MoebiusTech/MecanumRobot-ArduinoMega2560/bord.jpg

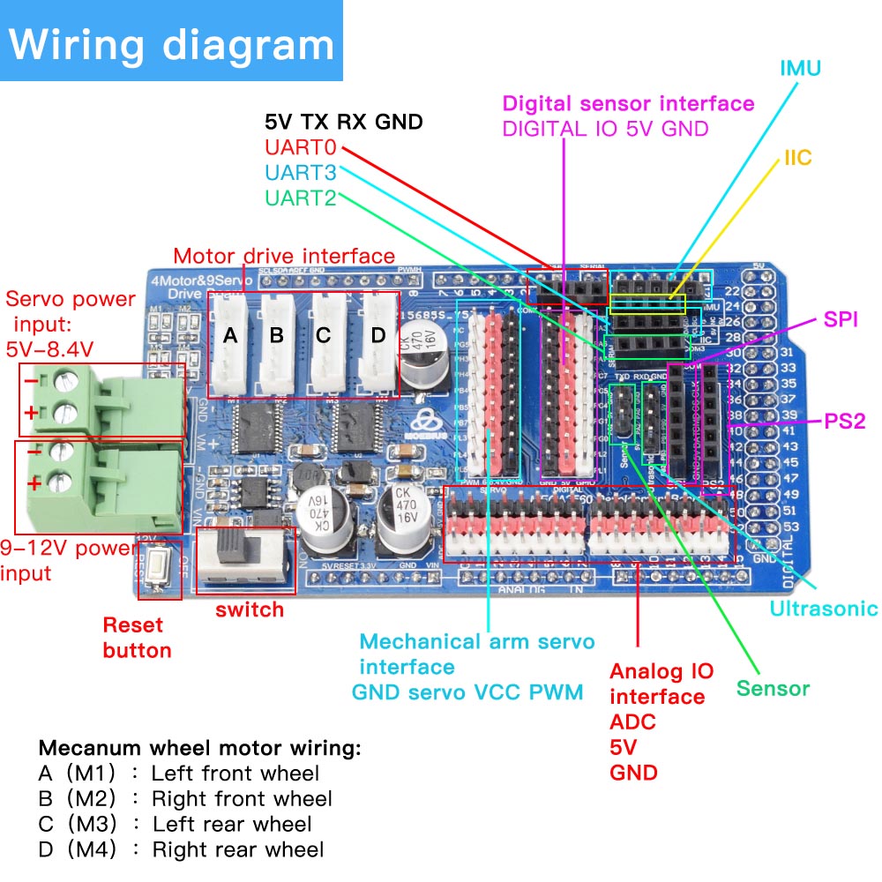
bord.jpg
