MoebiusTech/MecanumRobot-ArduinoMega2560/Encoder interface.png

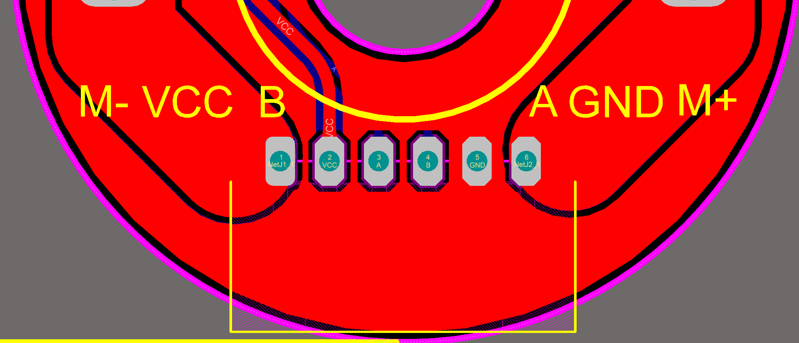
Encoder interface.png
