MoebiusTech/MecanumRobot-ArduinoMega2560/MecanumRobotPS2control.png

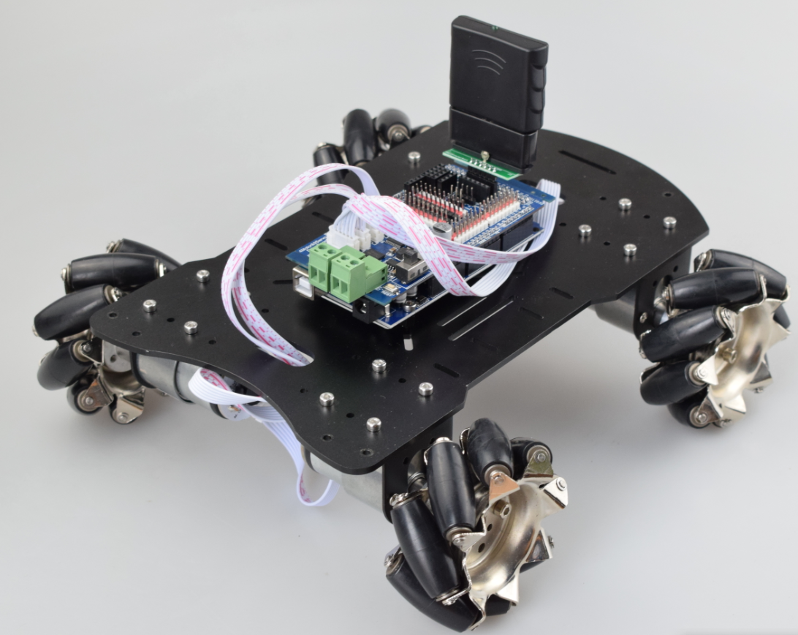
MecanumRobotPS2control.png
