MoebiusTech/MecanumRobot-ArduinoMega2560/Assembly Steps/01 - Attach Wheel Mounts.jpeg

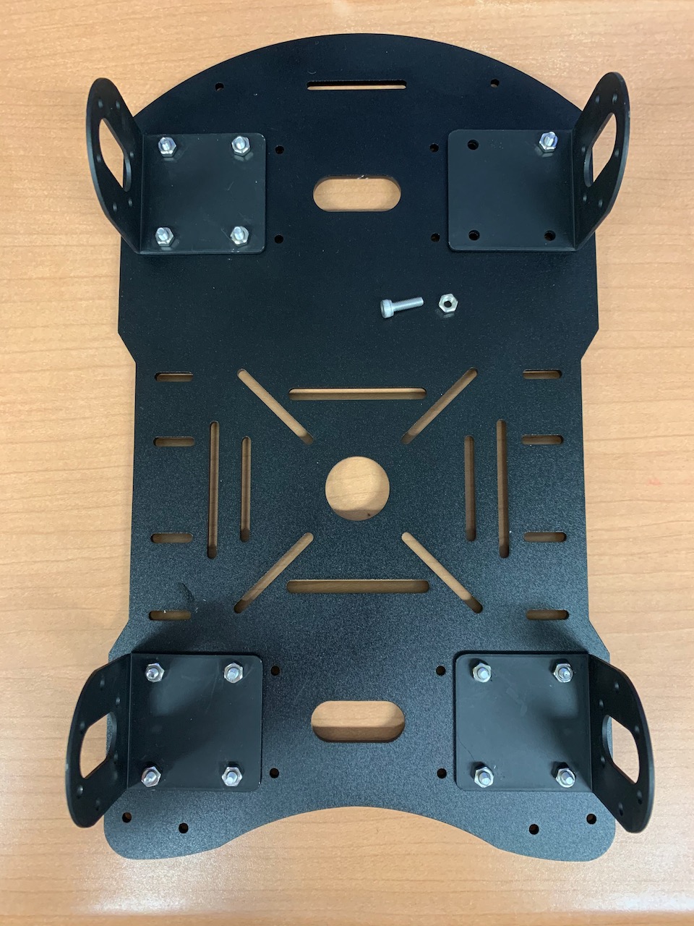
Assembly Steps/01 - Attach Wheel Mounts.jpeg
