MoebiusTech/MecanumRobot-ArduinoMega2560/Assembly Steps/02 - Plan Motors so Connectors are Oriented Inwards.jpeg

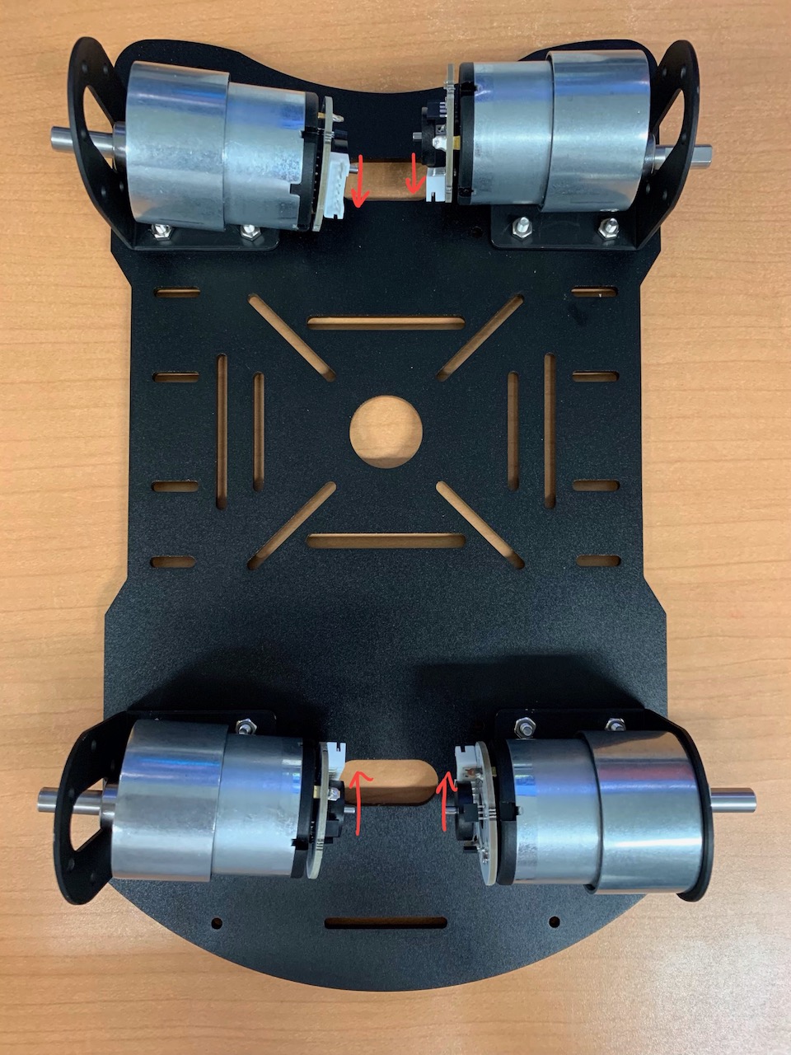
Assembly Steps/02 - Plan Motors so Connectors are Oriented Inwards.jpeg
