MoebiusTech/MecanumRobot-ArduinoMega2560/Assembly Steps/03 - Screw in Motors.jpeg

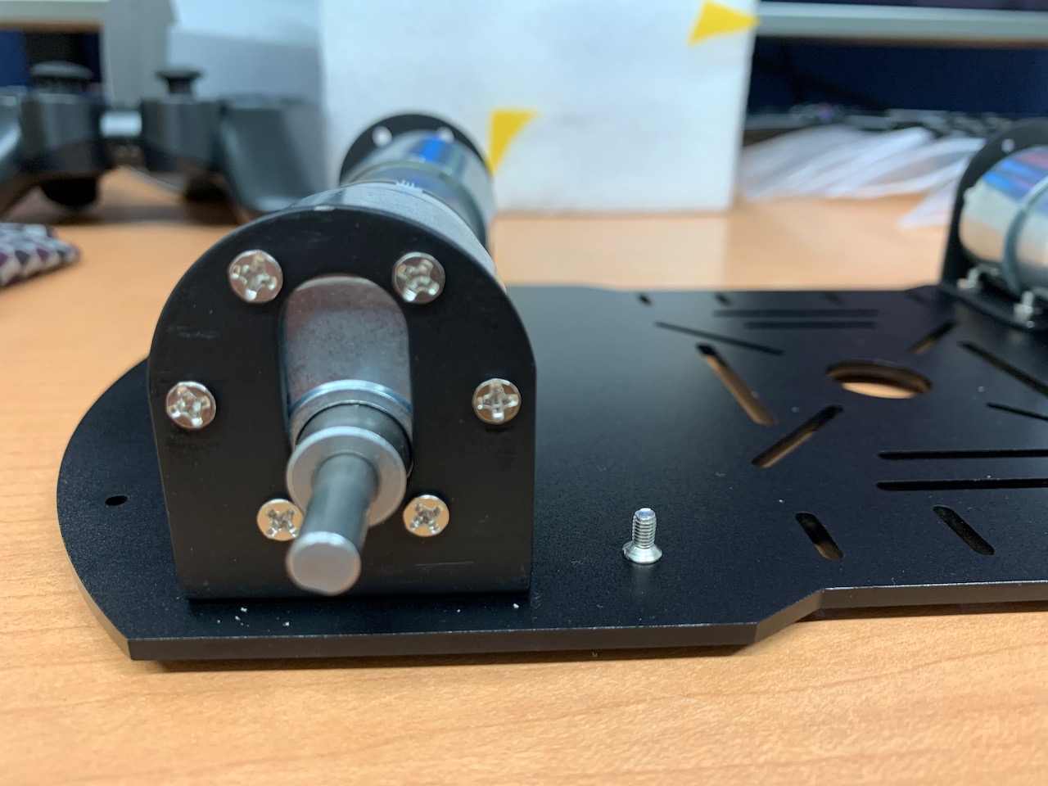
Assembly Steps/03 - Screw in Motors.jpeg
