MoebiusTech/MecanumRobot-ArduinoMega2560/Assembly Steps/04 - Prepare Wheel Assembly.jpeg

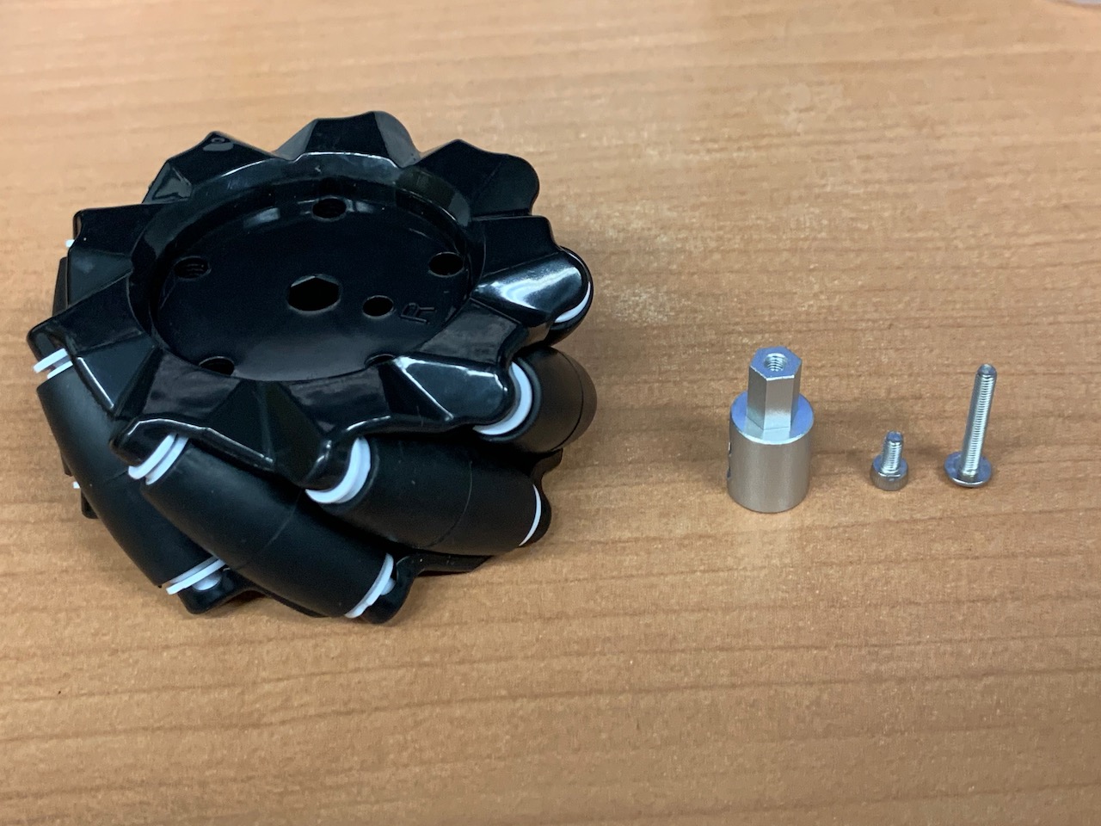
Assembly Steps/04 - Prepare Wheel Assembly.jpeg
