MoebiusTech/MecanumRobot-ArduinoMega2560/Assembly Steps/05 - Screw in Axle.jpeg

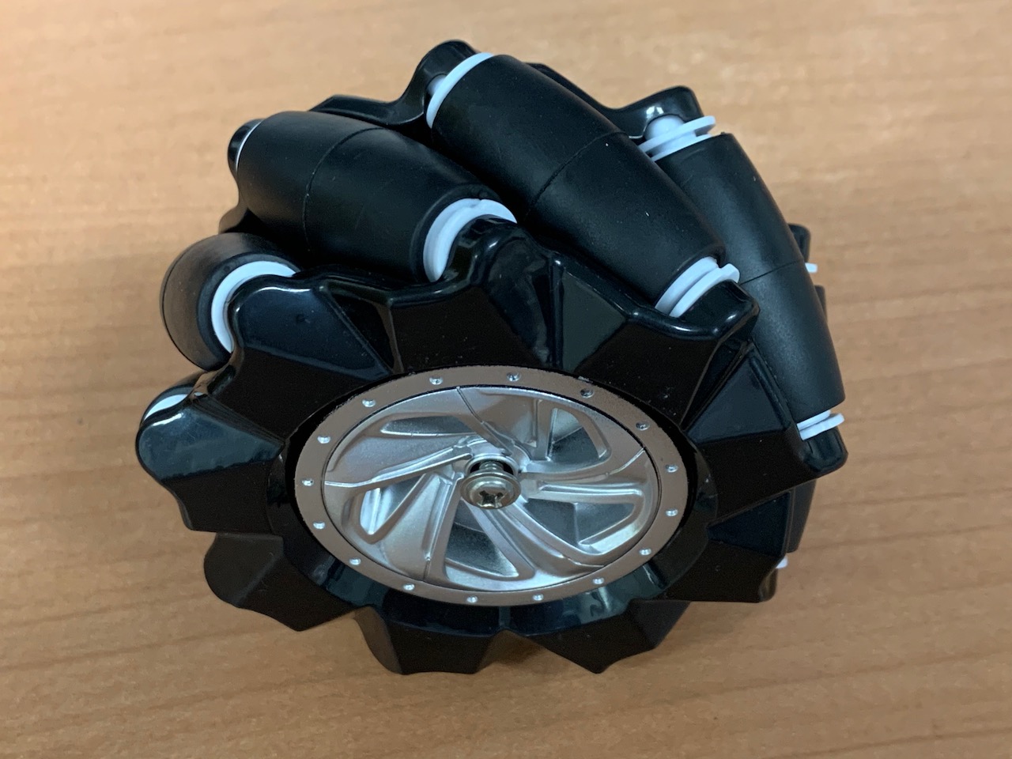
Assembly Steps/05 - Screw in Axle.jpeg
