MoebiusTech/MecanumRobot-ArduinoMega2560/Assembly Steps/06 - Prepare Set Screw.jpeg

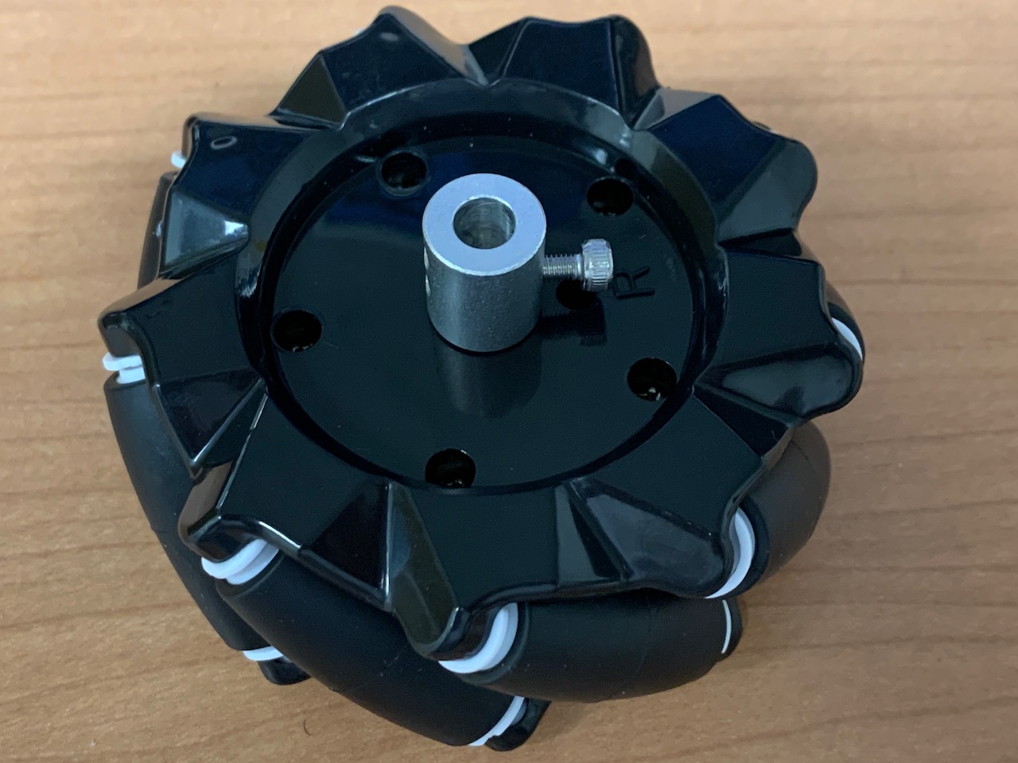
Assembly Steps/06 - Prepare Set Screw.jpeg
