MoebiusTech/MecanumRobot-ArduinoMega2560/Assembly Steps/07 - Wheels Ready.jpeg

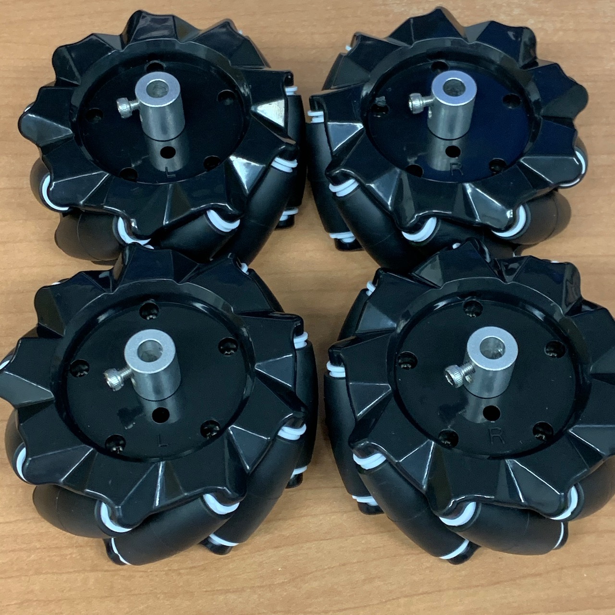
Assembly Steps/07 - Wheels Ready.jpeg
