MoebiusTech/MecanumRobot-ArduinoMega2560/Assembly Steps/08 - Align Wheel Set Screw to Axel Flat Area.jpeg

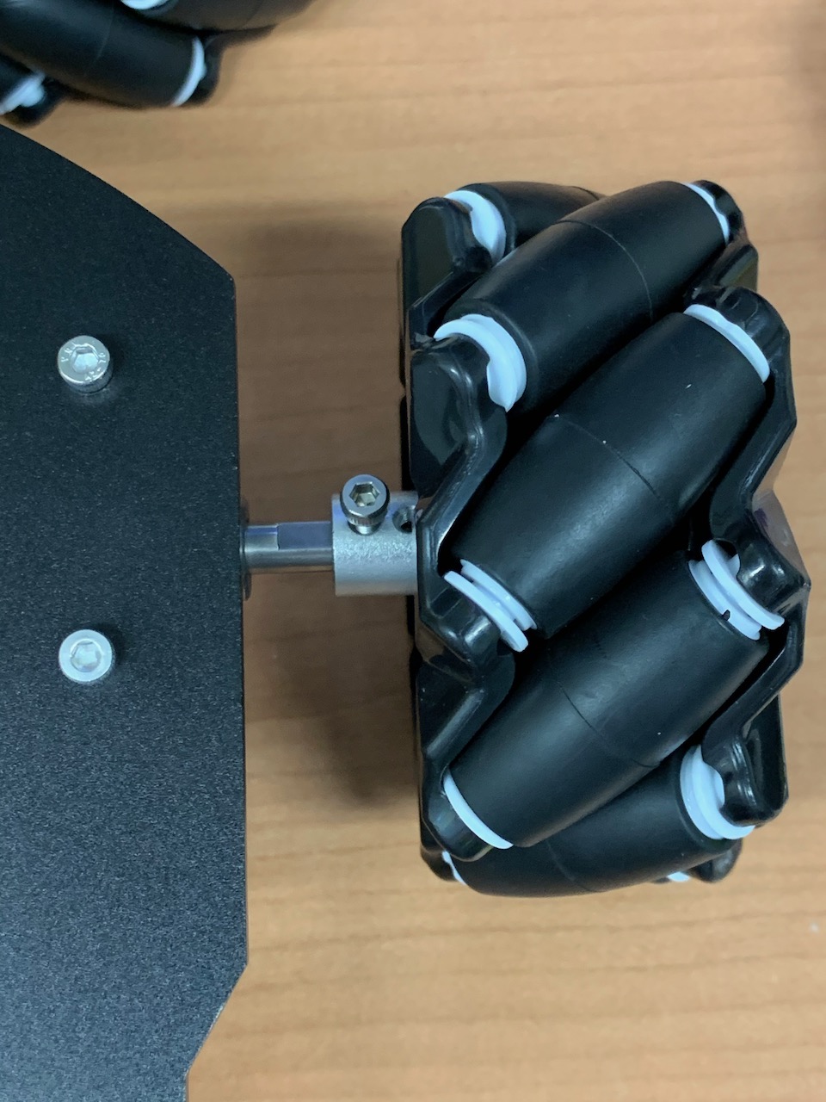
Assembly Steps/08 - Align Wheel Set Screw to Axel Flat Area.jpeg
