MoebiusTech/MecanumRobot-ArduinoMega2560/Assembly Steps/09 - Firmly Apply Set Screw.jpeg

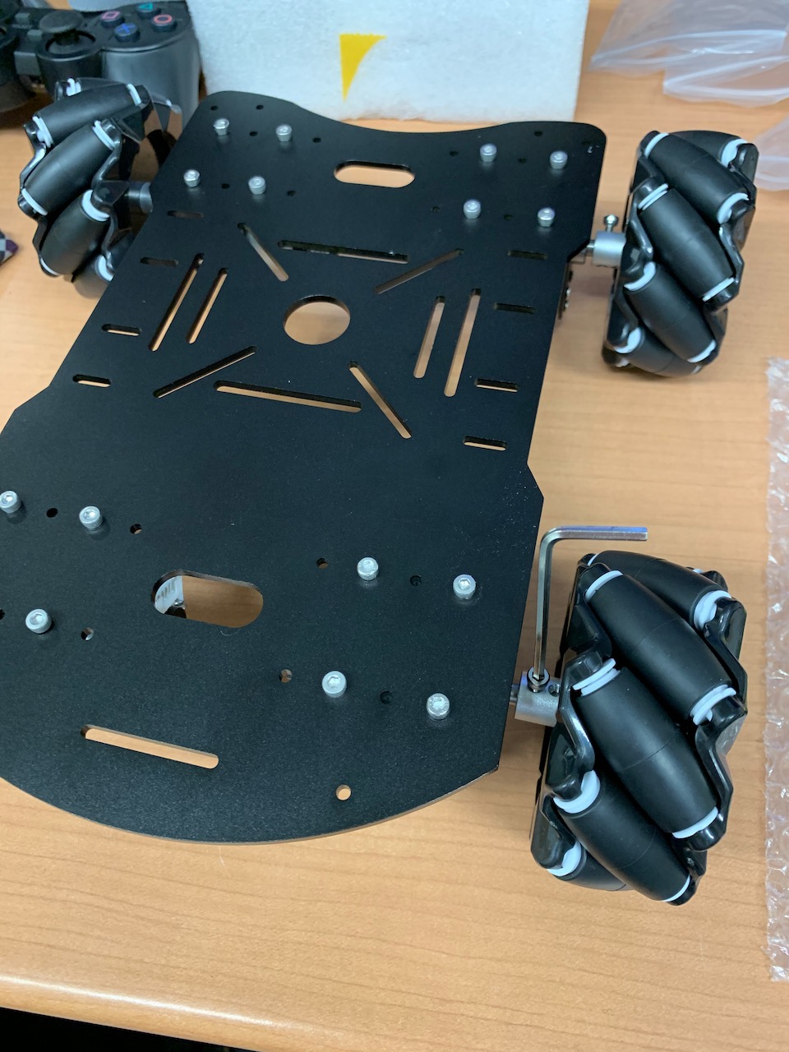
Assembly Steps/09 - Firmly Apply Set Screw.jpeg
