MoebiusTech/MecanumRobot-ArduinoMega2560/Assembly Steps/10 - Prepare Arduino Mega2560.jpeg

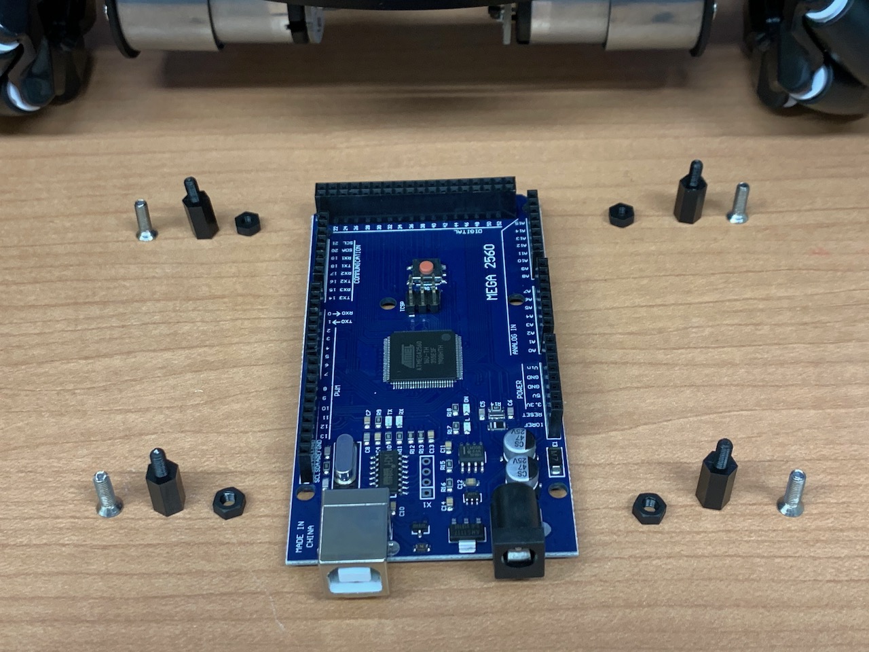
Assembly Steps/10 - Prepare Arduino Mega2560.jpeg
