MoebiusTech/MecanumRobot-ArduinoMega2560/Assembly Steps/11 - Plan Mounting Points.jpeg

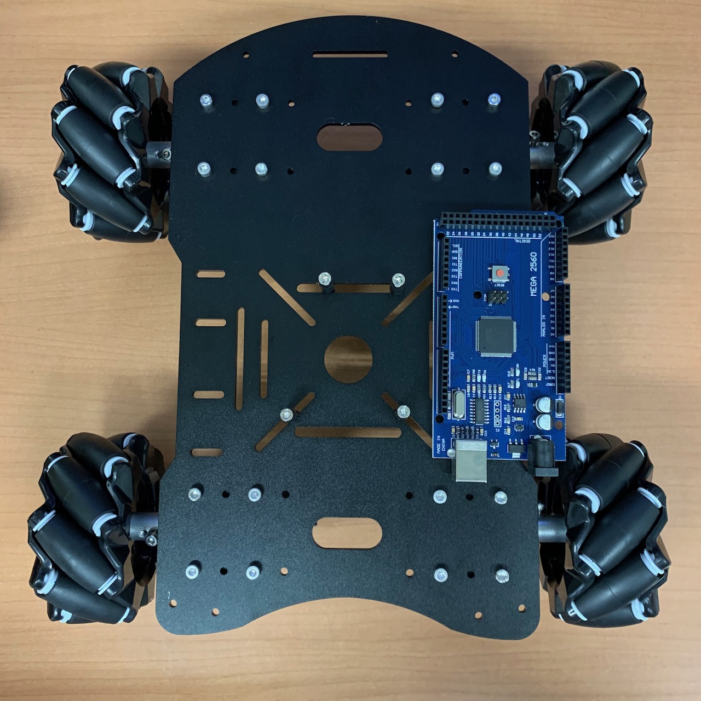
Assembly Steps/11 - Plan Mounting Points.jpeg
