MoebiusTech/MecanumRobot-ArduinoMega2560/Assembly Steps/12 - Mount Mega2560.jpeg

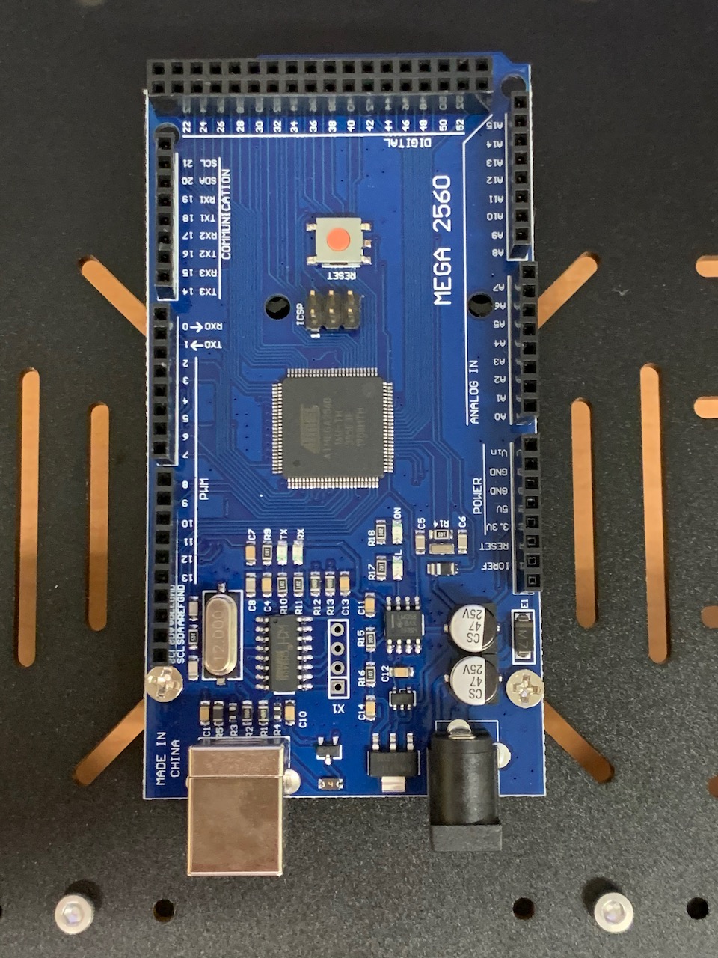
Assembly Steps/12 - Mount Mega2560.jpeg
