MoebiusTech/MecanumRobot-ArduinoMega2560/Assembly Steps/12 - Prepare IO Shield.jpeg

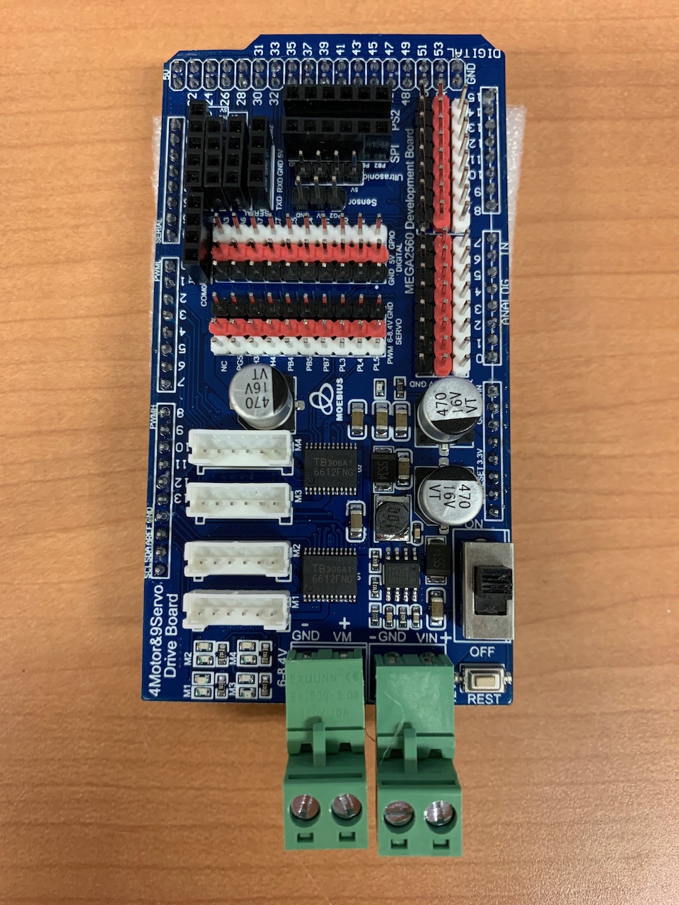
Assembly Steps/12 - Prepare IO Shield.jpeg
