MoebiusTech/MecanumRobot-ArduinoMega2560/Assembly Steps/13 - Align IO Shield to Mega2560.jpeg

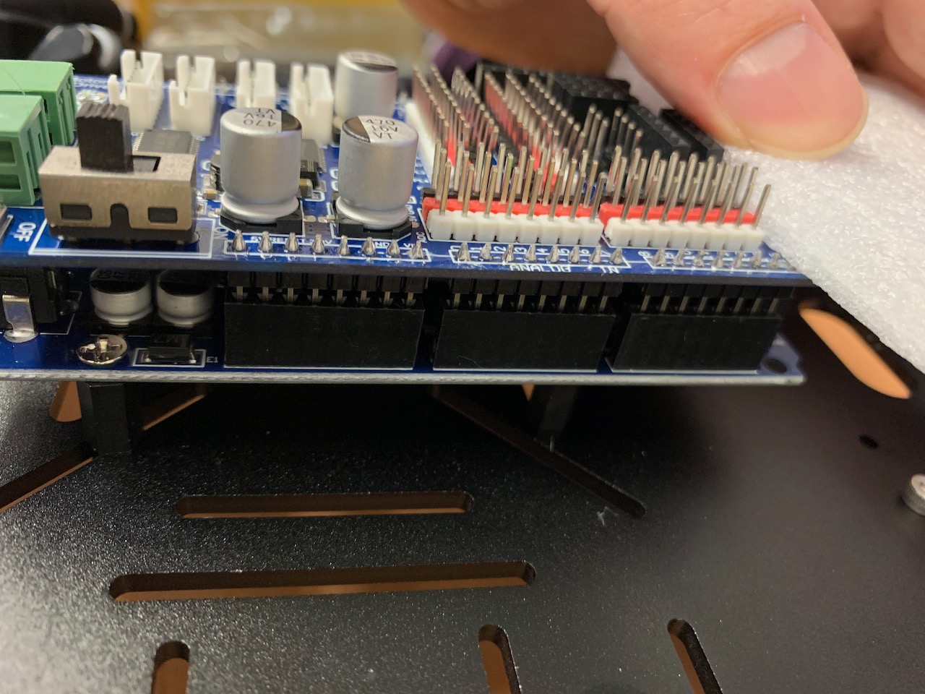
Assembly Steps/13 - Align IO Shield to Mega2560.jpeg
