MoebiusTech/MecanumRobot-ArduinoMega2560/Assembly Steps/14 - Use Foam to Press Firmly.jpeg

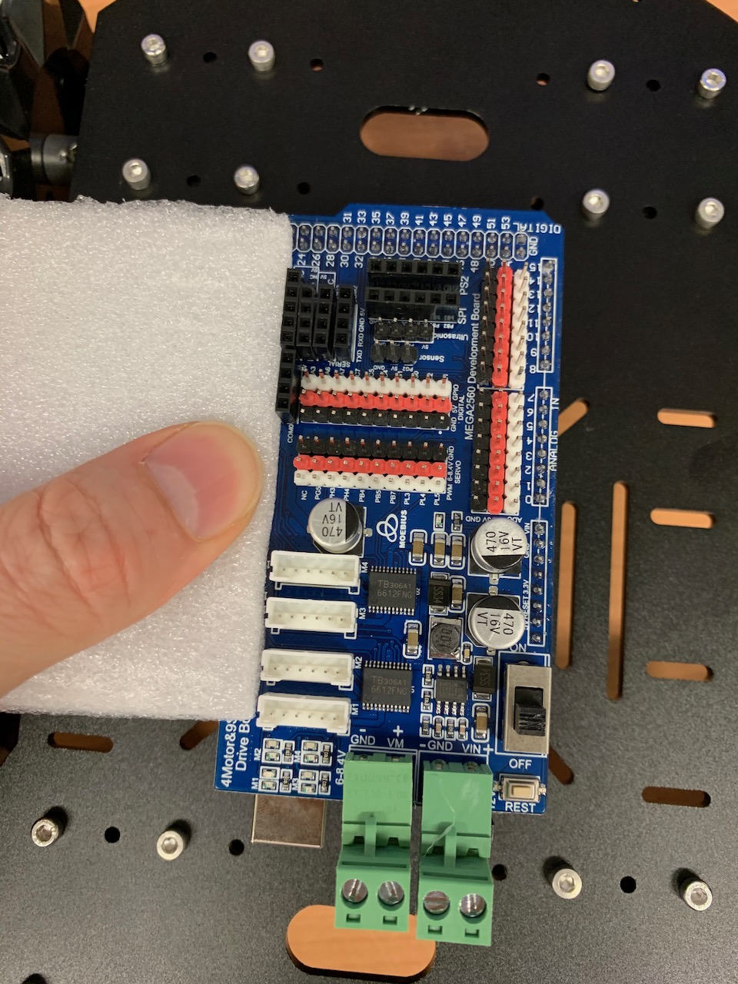
Assembly Steps/14 - Use Foam to Press Firmly.jpeg
