MoebiusTech/MecanumRobot-ArduinoMega2560/Assembly Steps/15 - Check Seating of Boards.jpeg

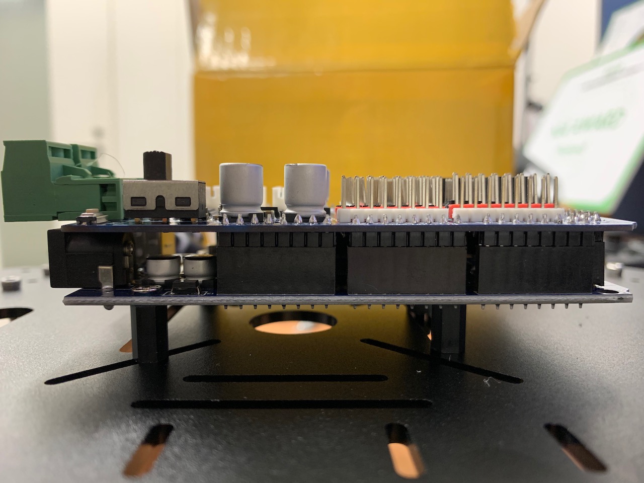
Assembly Steps/15 - Check Seating of Boards.jpeg
