MoebiusTech/MecanumRobot-ArduinoMega2560/Assembly Steps/16 - Prepare Motor Cables.jpeg

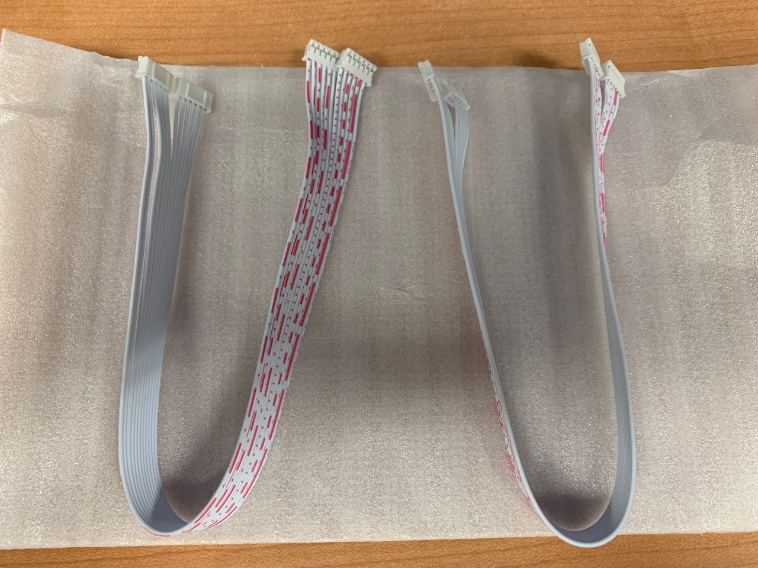
Assembly Steps/16 - Prepare Motor Cables.jpeg
