MoebiusTech/MecanumRobot-ArduinoMega2560/Assembly Steps/17 - Plug in Front Motors.jpeg

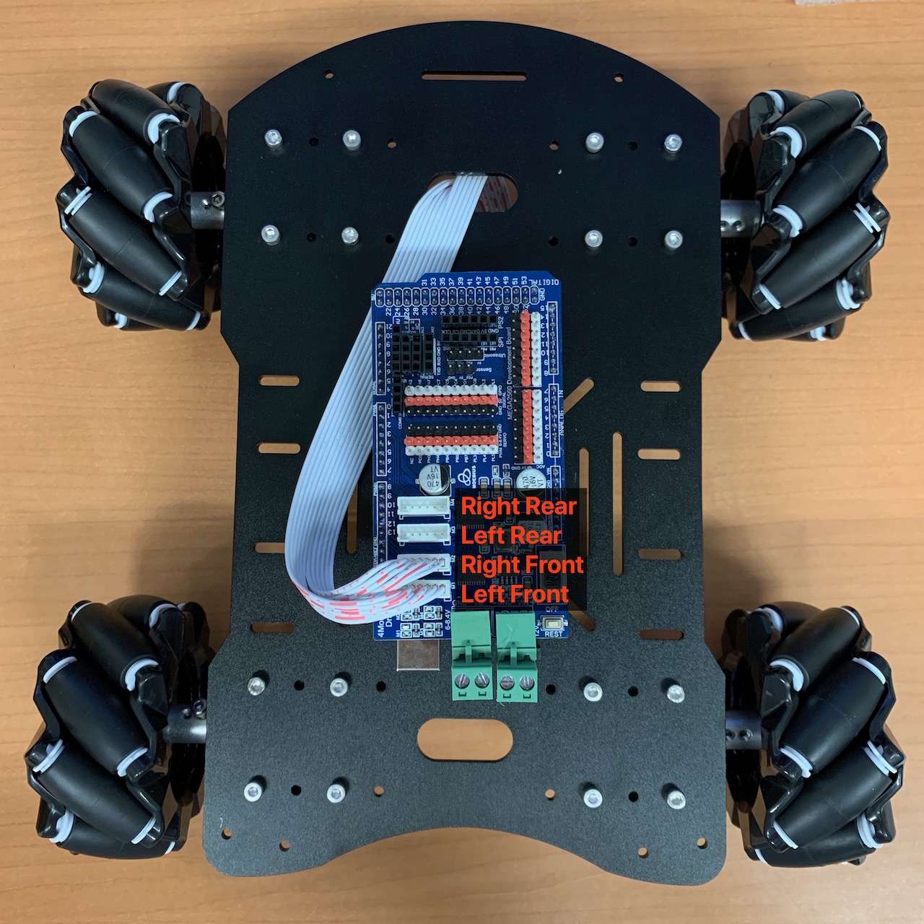
Assembly Steps/17 - Plug in Front Motors.jpeg
