MoebiusTech/MecanumRobot-ArduinoMega2560/Assembly Steps/18 - Front Motors Underside.jpeg

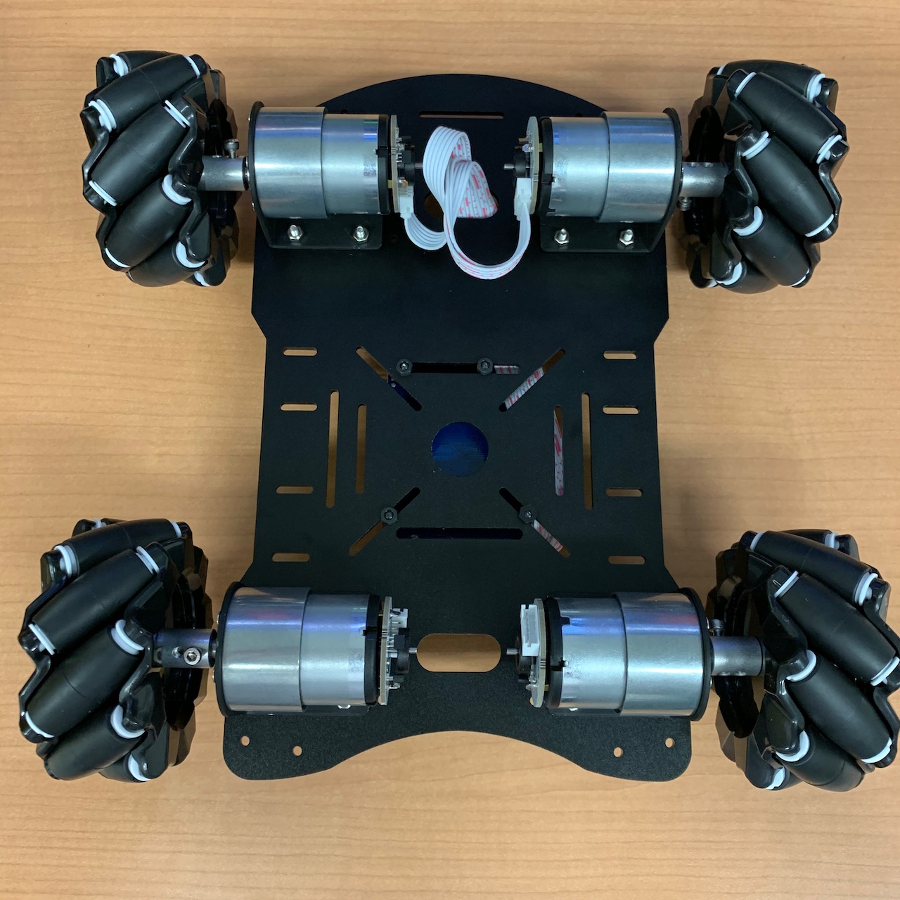
Assembly Steps/18 - Front Motors Underside.jpeg
