MoebiusTech/MecanumRobot-ArduinoMega2560/Assembly Steps/19 - Plug in Rear Motors (via center hole).jpeg

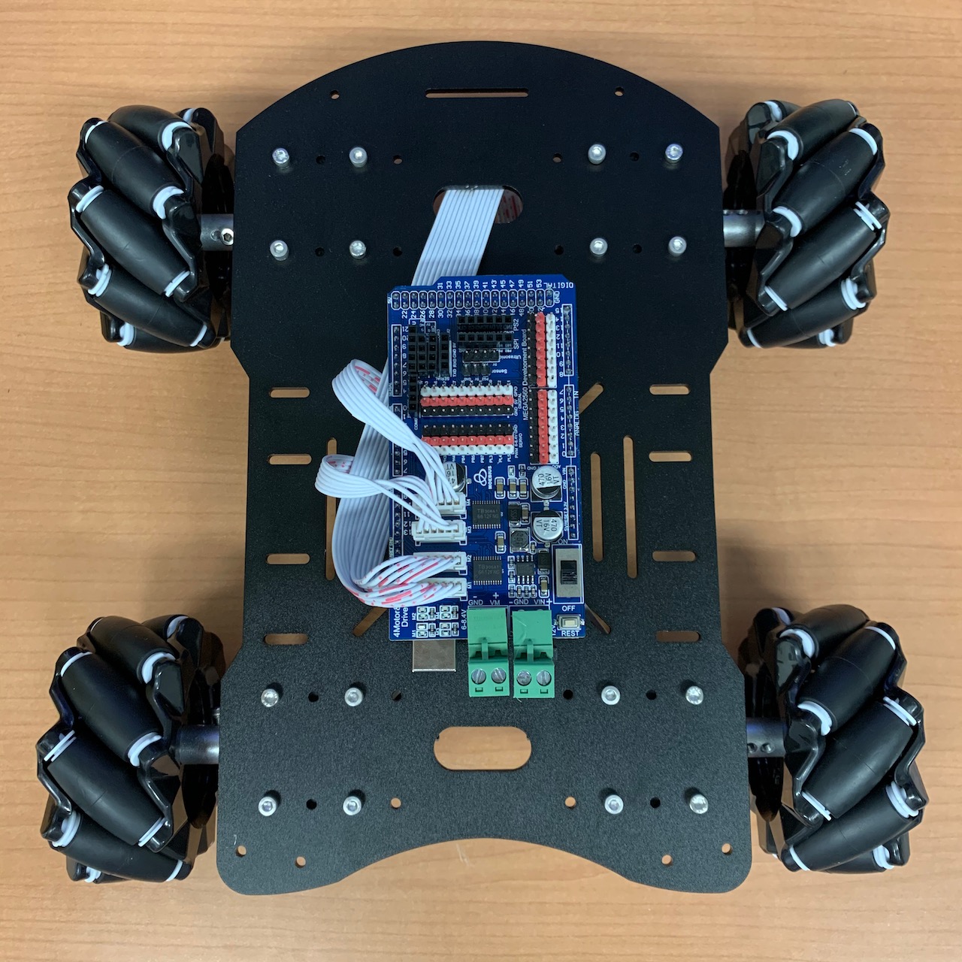
Assembly Steps/19 - Plug in Rear Motors (via center hole).jpeg
