MoebiusTech/MecanumRobot-ArduinoMega2560/Assembly Steps/20 - Rear Wheels via Center Hole.jpeg

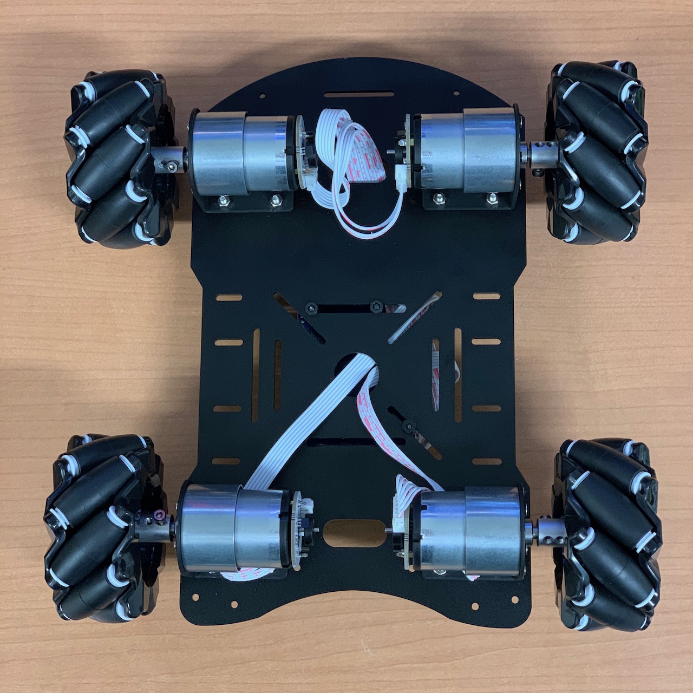
Assembly Steps/20 - Rear Wheels via Center Hole.jpeg
