MoebiusTech/MecanumRobot-ArduinoMega2560/Assembly Steps/21 - Plug in PS2 Receiver.jpeg

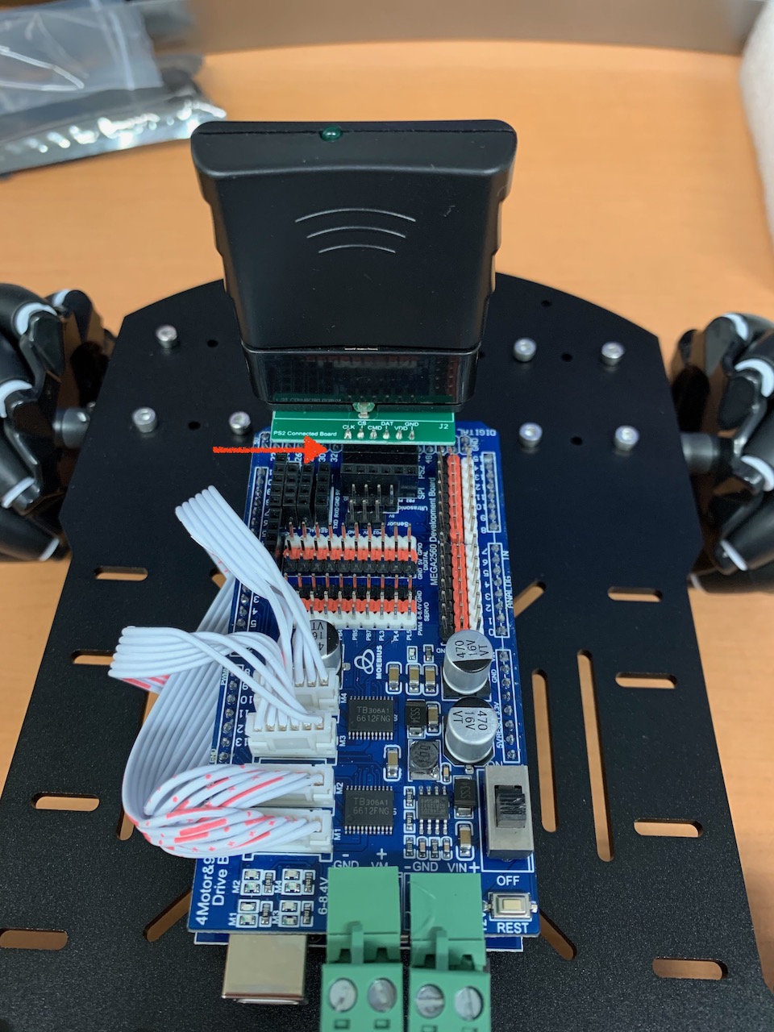
Assembly Steps/21 - Plug in PS2 Receiver.jpeg
