MoebiusTech/MecanumRobot-ArduinoMega2560/Assembly Steps/22 - PS2 Receiver Alignment.jpeg

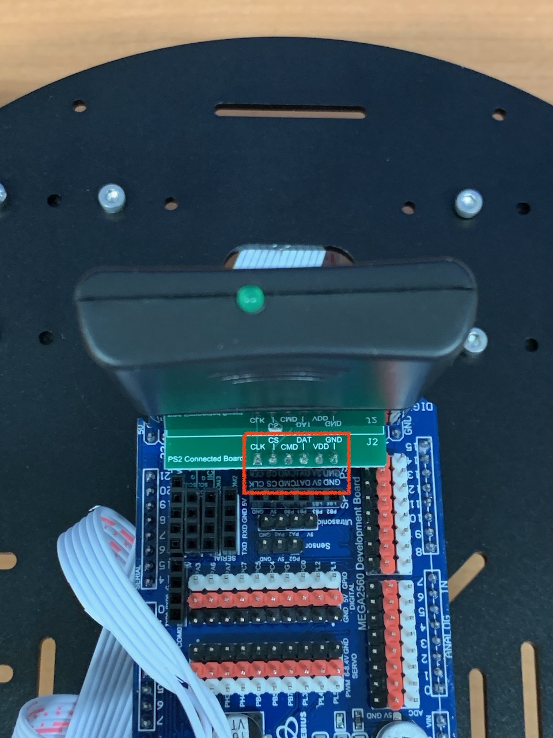
Assembly Steps/22 - PS2 Receiver Alignment.jpeg
