MoebiusTech/MecanumRobot-ArduinoMega2560/Assembly Steps/Pay attention to the direction of installing the wheels.jpg

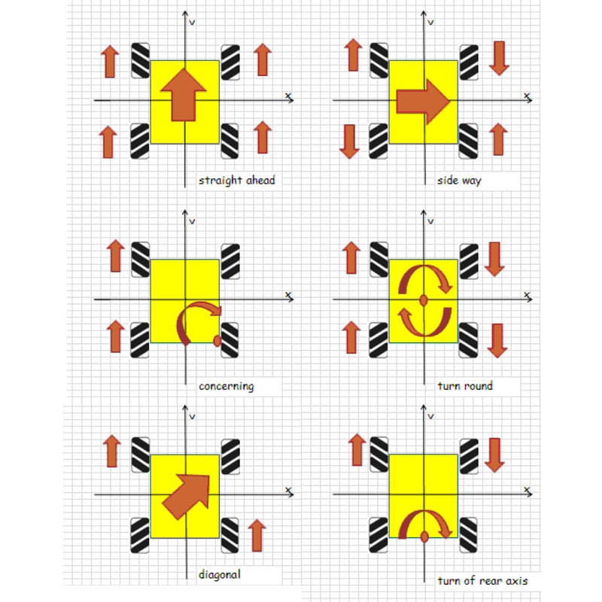
Assembly Steps/Pay attention to the direction of installing the wheels.jpg
