MoebiusTech/MecanumRobot-ArduinoMega2560/(threads)

Thread 1 (2019-11-20):

stm32

GreenGhostMan, 2019-11-20:
Where is stm32 repo and pin diagram . I want to contribute!

MoebiusTech, 2020-05-24:
The controller of stm32 will be online as soon as possible

Closed 2020-08-08.

Thread 4 (2020-05-12):

PS2 Analog issue

olaf-h, 2020-05-12:
It looks like the car is not going straight forwarded or backward with the analog joystick. When I activate the analog joystick by pressing L1 or R1 and use the left stick to control the car, it only turns. Could'nt find out the reason so far. If I use the buttons, everything is fine.

MoebiusTech, 2020-05-24:
Check if the direction of the control wheel of this code is inconsistent

ArabicRobotics, 2020-07-11:
I installed the driver :
but the bluetooth not lighting .
the motor lighting but not running
which file make like test or demo to check the parts
the serial monitor show :
========
Controller mode not matched or no controller found
Expected 0x41, 0x73 or 0x79, but got FF
No controller found, check wiring, see readme.txt to enaController mode not matched or no controller found
=========
I have 12V and 11V baterry
I have arduino uno and mega Both not working

MoebiusTech, 2020-07-13:
Hello, where is your order? Please send the video how did you operate?

moebius@mbeus.com

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

ArabicRobotics, 2020-07-24:
send here ?
moebius@mbeus.com

MoebiusTech, 2020-08-07:
yes

Thread 7 (2021-01-02):

Motor driver board M4 connector.

kpmerrill, 2021-01-02:
Schematic diagram 4Motor&9Servo
J17 pin 3(PA1) does not connect to 2560Mega pin 23?
J17 pin 3(PA1) appears to connect to 2560Mega pin ADC1?

Is there a fix for this I can do on the board?

Thread 8 (2021-02-08):

Ultrasonic sensor pins

soerenbrockmann, 2021-02-08:
HI, I just connected my Ultrasonic sensor to your motor driver board.

According to the labels, I should connect them to VCC, PA2, PA0, GND.

In code, I was setting the pins like that:

```
//Ultrasonic
#define trigPin A2
#define echoPin A0
```

However, the response is always 0. I tried it with an Arduino UNO and it worked perfectly fine.

Are those the correct pins in code?

soerenbrockmann, 2021-02-09:
Ok, I found it. I have to use the digital pins of the Arduino Mega board:

```
#define trigPin 24 // PA2
#define echoPin 22 // PA0
```

Closed 2021-02-09.

Thread 9 (2021-03-03):

Misleading and inconsistent wheel installation instructions

Namlak, 2021-03-03:
The instructions say to be careful about wheel installation, but there are conflicting instructions.

If you install the wheels by putting L and R wheels on the left and right sides, the rear axle is incorrect.  Photo 11 shows them installed **incorrectly** this way.

The **drawing** showing wheel turning directions is correct, however.

A student or novice will not know that this is wrong and the chassis does not drive correctly.  And they cannot check the instructions or the wheel labels, because some of them are wrong.

Nixies, 2023-06-26:
Hello Namlak,
We have modified some Arduino files to make it work...

Namlak, 2023-06-26:
The main issue here is that some of the photos show incorrect wheel orientation.  If you don't want to take the photos again, maybe add a line of text on each of the wrong ones making a note of it and instructing the user to go to the correct one (the "pay attention" one).

These are wrong:
https://github.com/MoebiusTech/MecanumRobot-ArduinoMega2560/blob/master/Assembly%20Steps/09%20-%20Firmly%20Apply%20Set%20Screw.jpeg

https://github.com/MoebiusTech/MecanumRobot-ArduinoMega2560/blob/master/Assembly%20Steps/11%20-%20Plan%20Mounting%20Points.jpeg

https://github.com/MoebiusTech/MecanumRobot-ArduinoMega2560/blob/master/Assembly%20Steps/17%20-%20Plug%20in%20Front%20Motors.jpeg

https://github.com/MoebiusTech/MecanumRobot-ArduinoMega2560/blob/master/Assembly%20Steps/18%20-%20Front%20Motors%20Underside.jpeg

https://github.com/MoebiusTech/MecanumRobot-ArduinoMega2560/blob/master/Assembly%20Steps/19%20-%20Plug%20in%20Rear%20Motors%20(via%20center%20hole).jpeg

https://github.com/MoebiusTech/MecanumRobot-ArduinoMega2560/blob/master/Assembly%20Steps/20%20-%20Rear%20Wheels%20via%20Center%20Hole.jpeg

This is correct:

https://github.com/MoebiusTech/MecanumRobot-ArduinoMega2560/blob/master/Assembly%20Steps/Pay%20attention%20to%20the%20direction%20of%20installing%20the%20wheels.jpg
