MoebiusTech/MecanumRobot-ArduinoMega2560/mega2560__2024-7（update）.pdf

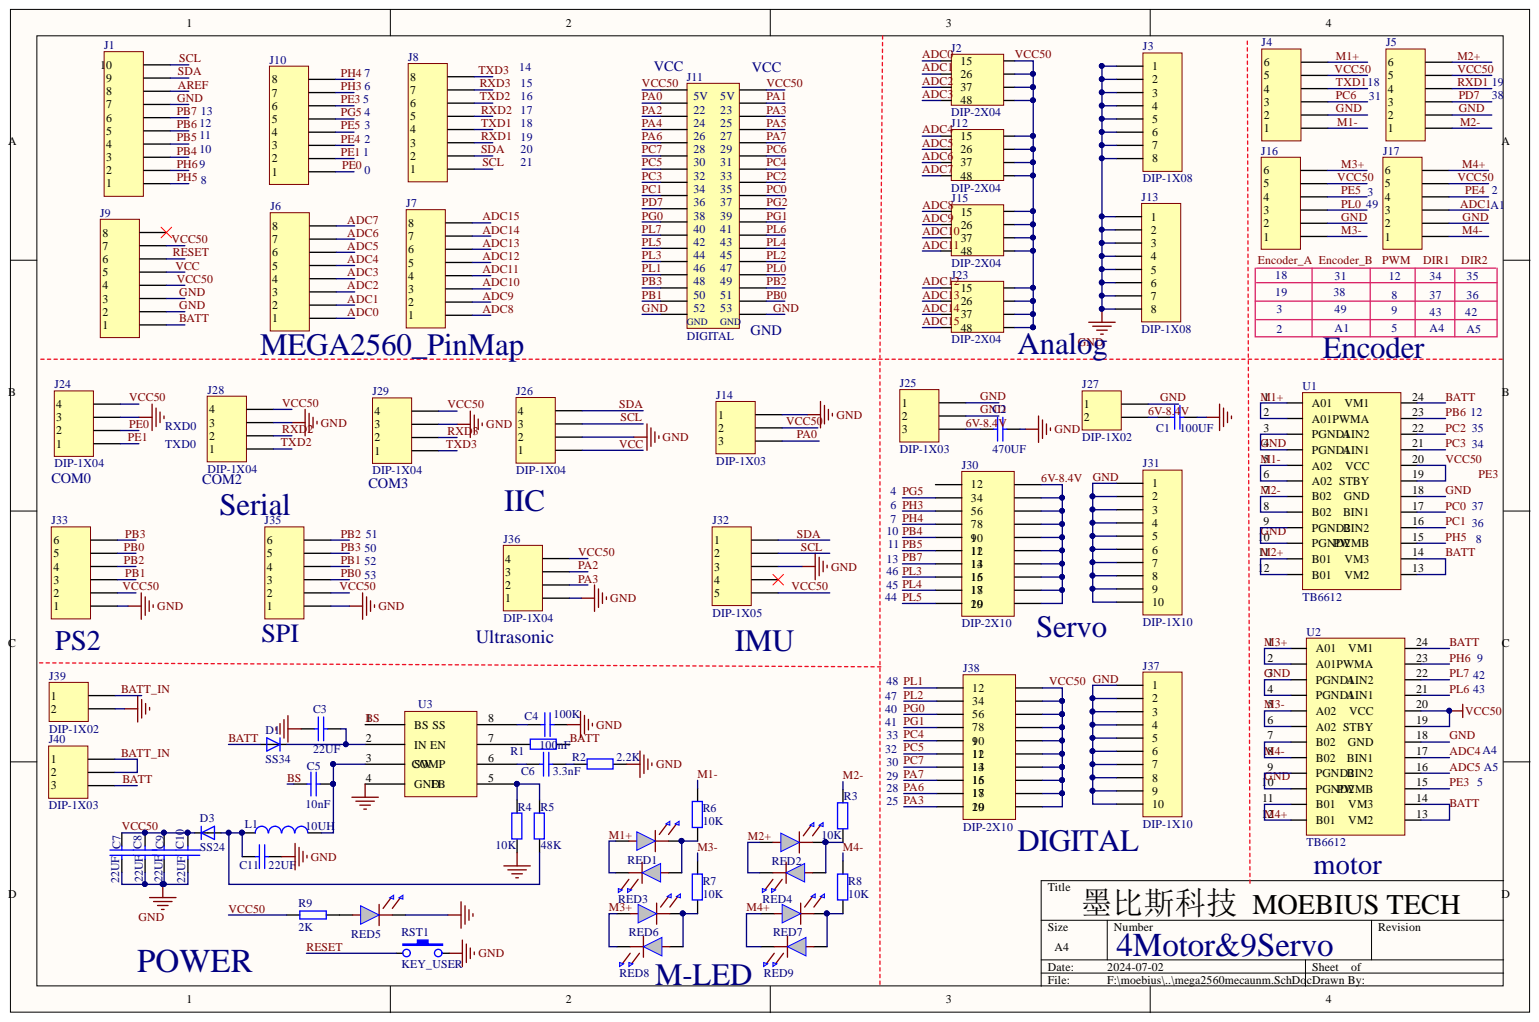
[picture p29: page 1]
