MoebiusTech/MecanumRobot-ArduinoMega2560/mega2560_sch.pdf

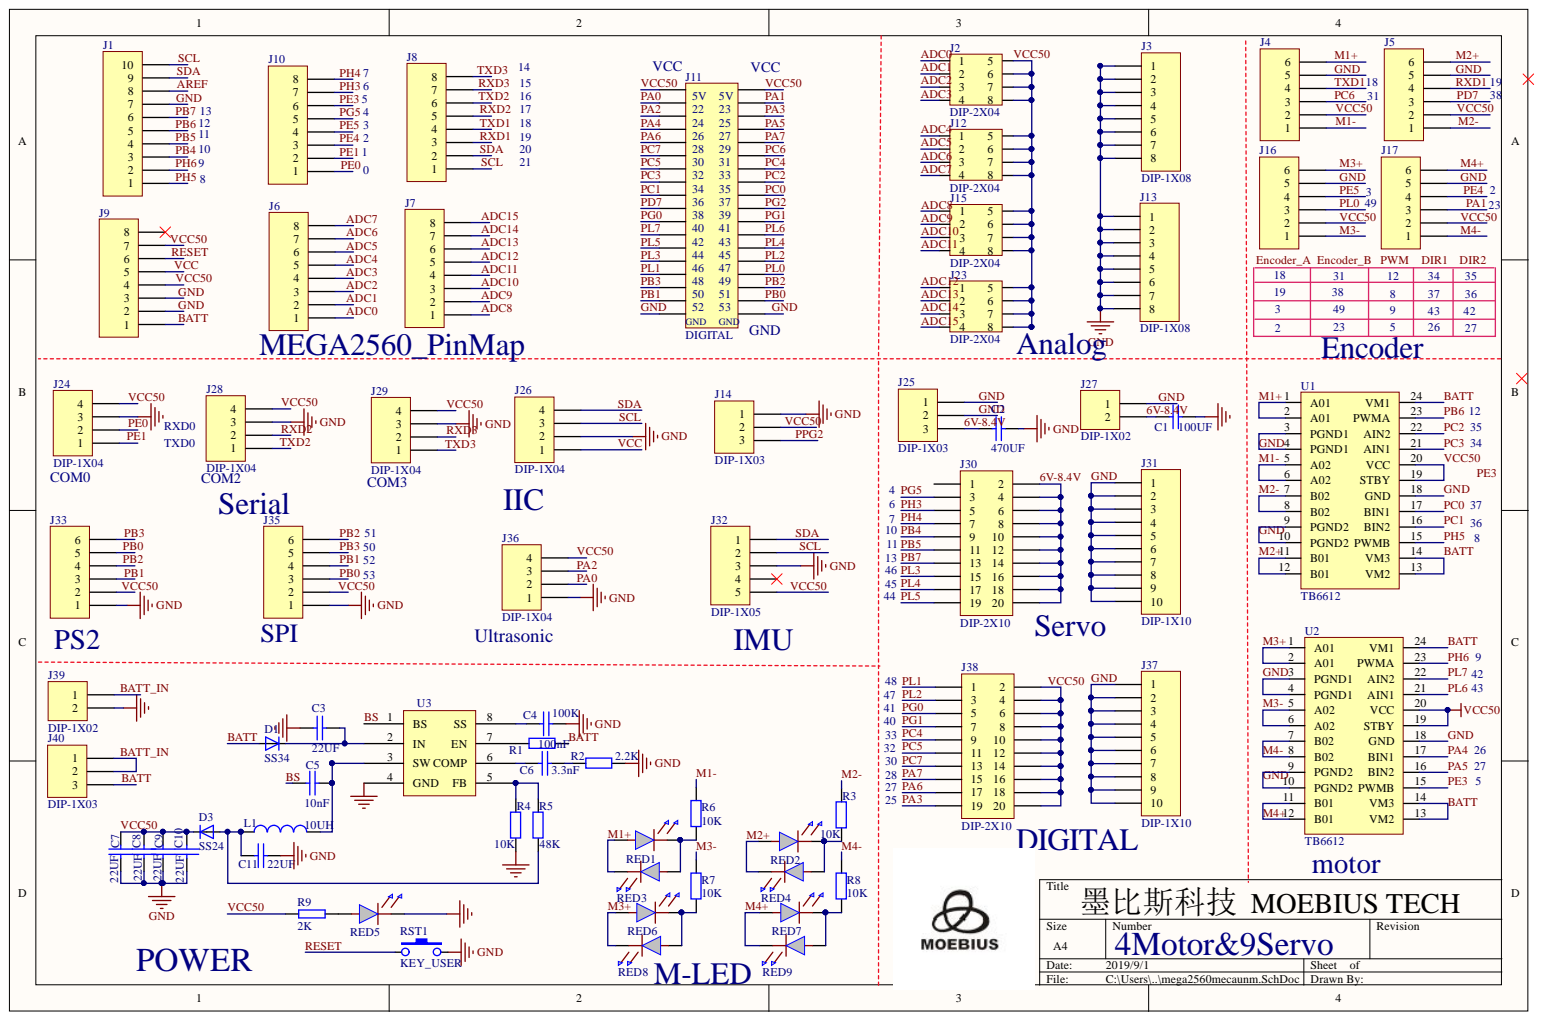
[picture p30: page 1]
