MoebiusTech/MecanumRobot-ArduinoMega2560/(commit log)

2019-10-25 MecanumRobot-ArduinoMega2560
    MecanumRobot-ArduinoMega2560code
2019-10-25 Mega 2560 Development board instruction picture
    Development board instruction picture
2019-10-25 4Motor9Servo sch
    MecanumRobot Circuit diagram
2019-10-25 PS2 interface need to be installed as the picture showed
    PS2 interface need to be installed as the picture showed
    [mega2560pin.xls]
2019-12-15 Move the ino into Arduino IDE compatible folder, and corrected motor drive directions.
    [PS2_2560.ino]
2019-12-15 Assembly Instructions
2020-01-19 Added turn left and turn right functions
    Associated green button with turning left and the blue button to turn right.
2020-02-04 Update PS2_2560.ino
    pin 26 27 change A4 A5
2020-02-04 MEGA2560 Encoder
    The coding motor of the communication control of the acceleration and deceleration of the handle push rod
2020-02-13 Update MecanumRobotPS2Control.ino
    Pin:27 26 change A4 A5
2020-02-17 Update MecanumRobotPS2Control.ino
    PIN 23 changed A1
2020-05-20 Pay attention to the direction of installing the wheels
    Pay attention to the direction of installing the wheels
2020-05-24 Mecanum_Robot_ROS
    IMU and odometer are not complete
2020-06-05 ros mecanum wheel car complete
    ros mecanum wheel car complete
2020-07-27 model airplane handle control
    MEGA2560 driver board through the remote control communication sample code of the model airplane handle
2020-09-12 Ch340 driver file
    windows and linux version
2020-10-02 ROS Car with STM32/MEGA2560 Controller Installation Manual
    ROS Car with STM32MEGA2560 Controller Installation Manual
2022-05-18 Update MecanumRobotPS2Control.ino
    changge the pin 9 ------ 6 .
2024-07-02 interface change
    we chage the VCC(5V) and GND position
2024-07-02 Update README.md
    exchange 5V GND position
